RivasMario/PublicSecurity96/README.md

# PublicSecurity96
96% Mechanical Keyboard PCB Kicad Files
