RivasMario/PublicSecurity96/(commit log)

2024-06-25 Initial Commit
    Initial Commit
    [PublicSecurity96.kicad_pcb, PublicSecurity96.kicad_sch]
2026-04-24 docs: diagnose heat/burn issue + 3 fix paths (FIX_PLAN.md)
    Root cause: U1 = XC6206P (SOT-23, 150mA, no thermal pad) cannot
    sustain RP2040 boot inrush. Schematic was copy-pasted from 6 unrelated
    projects (60%_mini/alice/Macropad/etc) — power section never validated
    for 96-key load.
    Fix paths documented:
    A. Rework existing PCB: swap U1 to AMS1117-3.3 + add bulk caps
    B. Redesign power section using Skyway-96 (working) as template
    C. Full RP2040-SMD redesign using deltasplit blueprint
    Includes verification checklist (bench supply 5V/200mA limit, continuity
    checks, footprint pin verification) before any re-power attempt.
2026-04-24 docs: step-by-step KiCad rework instructions for power section
    Path B from FIX_PLAN.md. Covers schematic edits (symbol swap U1
    XC6206->AMS1117 with pin remap), cap upgrades (10uF in/out), fuse
    spec, PCB editor steps (thermal pad copper pour for SOT-223), DRC/ERC
    verification, JLCPCB BOM additions (C6186, C15850, C2685389), and
    bench-supply bring-up procedure with 200mA current limit.
    Branch fix/power-section-skyway96-style protects main while reworking.
2026-04-24 wip: U1 swap XC6206->AMS1117-3.3, bump LDO caps to 10uF
    Schematic edits done in KiCad GUI:
    - U1: Regulator_Linear:AMS1117-3.3 (was XC6206PxxxMR), JLCPCB C6186
    - LDO input + output caps: 1uF -> 10uF for AMS1117 stability
    - Added JLCPCB part# custom field column
    - Started placing PWR_FLAG (+5V done, +3V3 in progress — wires off-grid)
    ERC state: 3 errors (power_pin_not_driven, fixing with PWR_FLAGs)
    + 829 cosmetic off-grid warnings (legacy from copy-paste schematic).
    PCM_marbastlib-mx still missing — install via PCM after restart.
    [PublicSecurity96.kicad_sch]
2026-04-29 kicad: swap U1 XC6206 -> AMS1117-3.3 (SOT-223 + C6186)
    [PublicSecurity96.kicad_sch]
2026-04-29 wip: place R20 27R on D+ (right-pad snap to pin 47 pending)
    [PublicSecurity96.kicad_sch]
